Ignacio-Prieto-Romero/CoVID19/README.md

# CoVID19
Designs that can be fabricated in a Fab Lab for CoVID19
