Ignacio-Prieto-Romero/CoVID19/Corte_Laser/Gafas Rev2/README.md

<h2>Updated Version of Laser cut Protective Googles</h2>

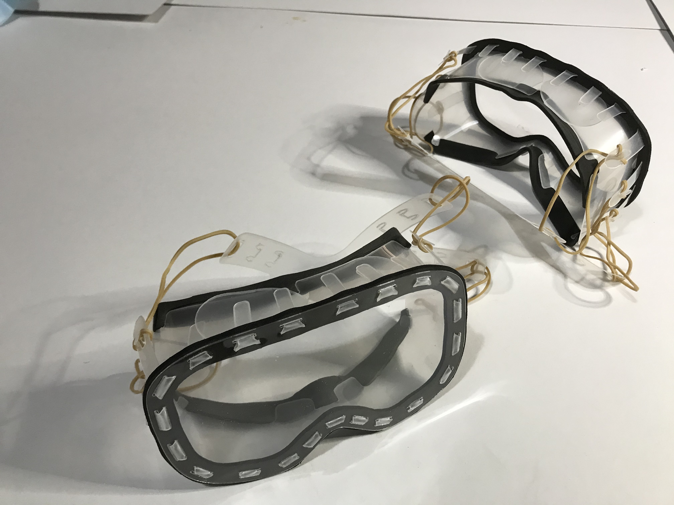
[picture p1: Corte_Laser/Gafas Rev2/IMAGES/IMG_2137.jpg]


This revision adresses concerns and issues that were stated during testing and feedback.

Main things changed are:

- Easily detachable (for sanitizing) foam inserts in the parts in contact with the face of the user.
- Changed the design of the back part that holds the rubber bands (we are using Number 14 or 140mm. diameter rubbers) to provide redundancy in case of failure and also added 1 size more, in case is needed.
- Lots little things regarding tolerances, for easier assembly process.

Important things:

We are not using rectangles anymore when cutting the PET visor. Those were so tiny, that heat resoldered them and its removal was very time consuming. No what we do is 3 different passes of straight lines with the lasercutter, defocusing them. Overall it takes much less time doing so.

Our Laser cutter is a Trotec Speedy 400 Co2 120W, so we can provide values and setup for this machine, but if you have othe machine, it'll be a little bit of trial and error, when you first test it. In order to do so, we provide a file for calibration purposes.

We also provide the file for the jig that we use to assemble the goggles. I cannot remark enough how valuable it is to speed up assembly times.

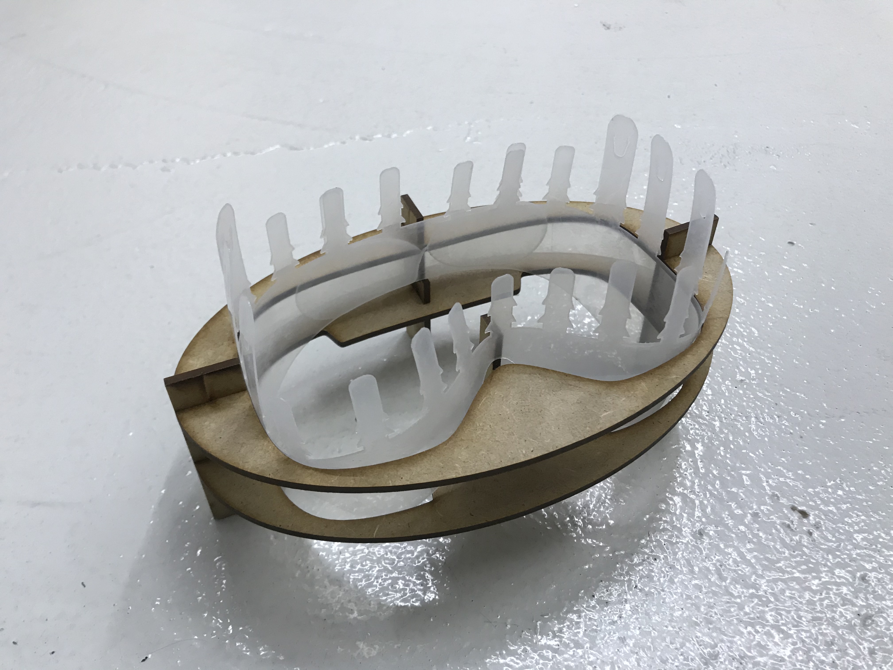
[picture p2: Corte_Laser/Gafas Rev2/IMAGES/IMG_2141.jpg]


Assembly process is pretty close to REV1

Hope you find the design useful and feel free to copy, reproduce or remix all or any part or solutions in it.

Thank you!
