Ignacio-Prieto-Romero/CoVID19/Corte_Laser/Gafas/README.md

<h2>Lasercut Protective Goggles</h2>

Desde Istituto Europeo di Design y través del de Fab Lab de su centro de innovación, hemos desarrollado un prototipo de gafas para la protección del personal sanitario, con el fin de **donarlas** a los hospitales  y contribuir a una mejor protección del personal sanitario **en reconocimiento y apoyo de su colosal labor.**

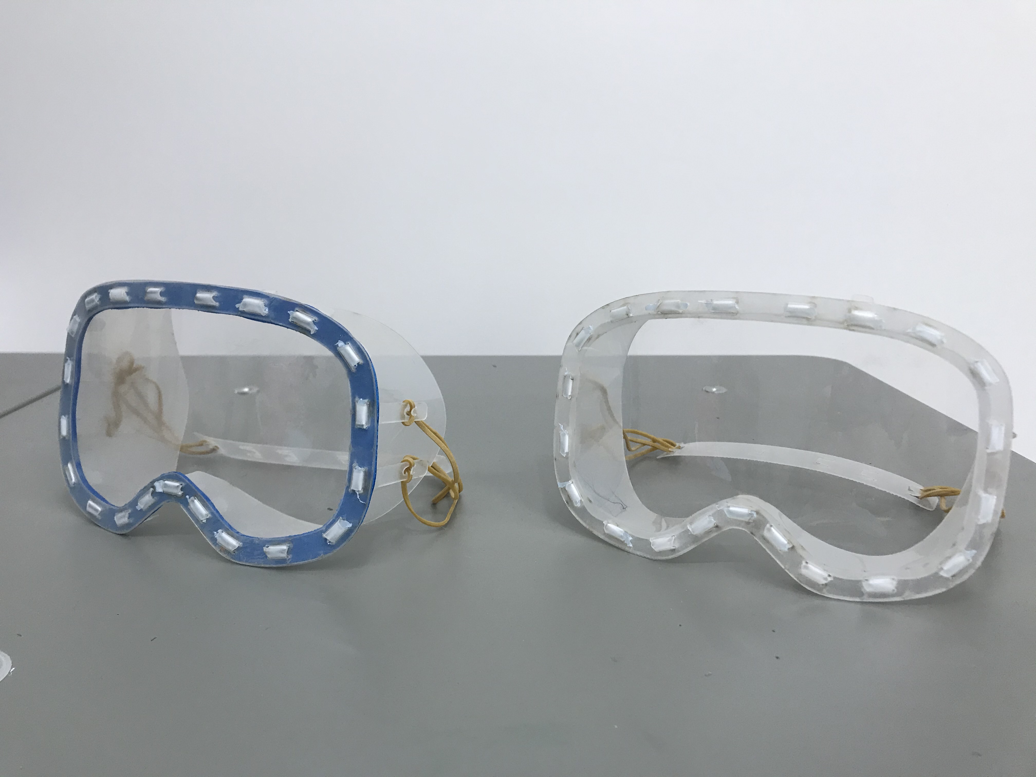
[picture p5: Corte_Laser/Gafas/images/IMG_2041.jpg]


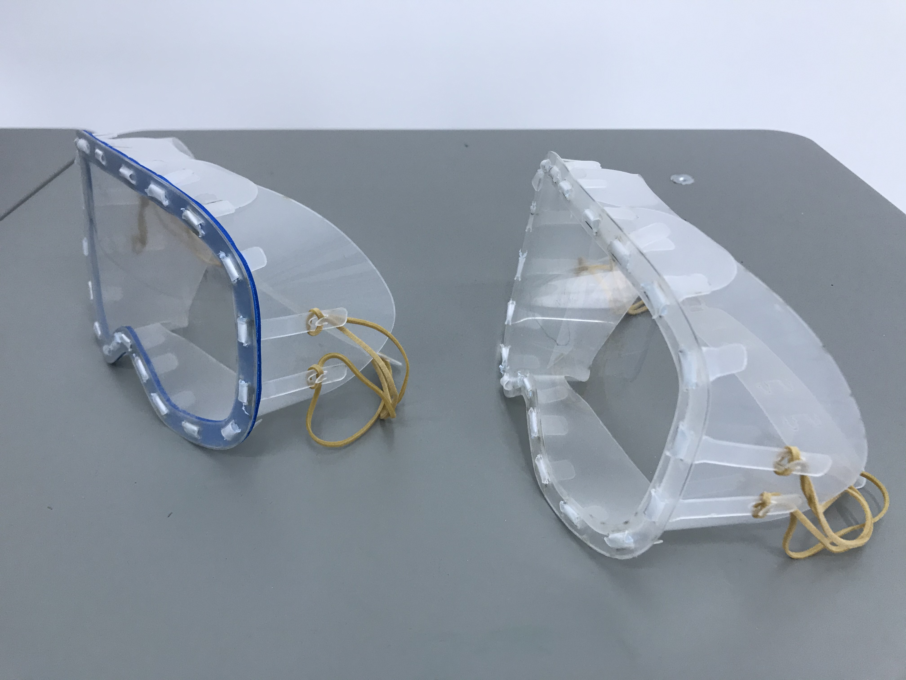
[picture p6: Corte_Laser/Gafas/images/IMG_2048.jpg]


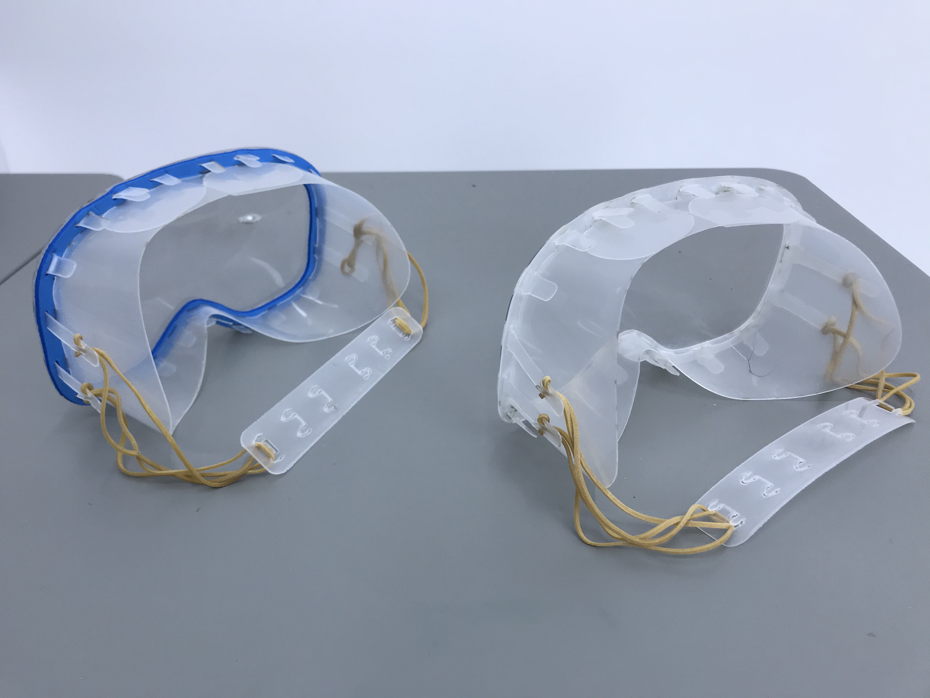
[picture p7: Corte_Laser/Gafas/images/IMG_2049.jpg]


<h4>CARACTERÍSTICAS FUNCIONALES</h4>

Las gafas se han diseñado con el propósito de **ofrecer un elevado grado de estanqueidad** evitando que el sanitario o quien las porte reciba salpicaduras, minimizando el riesgo de transmisión del coronavirus Covid-19 a través de las lágrimas y secreciones conjuntivales.

Se ha testado su capacidad anti vaho/anti empañamiento, siendo esta eficiente en entornos controlados de humedad y temperatura.

Están **diseñadas para una mejor adaptación a su uso con gafas graduadas, mascarillas y EPIs. Se recomienda especialmente su utilización con cofia y mascarilla.**

Se ajustan a la cabeza a través de unas gomas y tienen una medida estándar basada en estudios antropométricos.

<h4>CARACTERÍSTICAS DE LOS MATERIALES UTILIZADOS EN LA FABRICACIÓN</h4>

- Polipropileno 0,5mm de espesor.

Es resistente al agua, por lo que evita el traspaso de humedad y de agua, por lo que es cumple con su función de protección.

La lámina de 0,5 mm puede ser sometida a flexión o fatiga siendo altamente resistente, pudiendo adaptarse a largas jornadas de trabajo.

Se puede desinfectar y lavar mediante jabones, soluciones de alcohol, etc., ya que es muy resistente a distintos químicos. Si la esterilización que se va a practicar a los equipos es mediante ozono, como se está haciendo en otras comunidades con el material cedido, aguanta entre 10-100 ciclos de esterilización.

- Espuma de polietileno 2-3mm de espesor.

Permiten asegurar un mejor sellado en la junta mecánica frontal.

Si la esterilización se realizase mediante ozono, se podría prescindir de esta y usar polipropileno, aunque mermaría la estanqueidad.

- PETG 0,5 mm

Permite transparencia de grado óptico y aguanta esterilización por ozono.

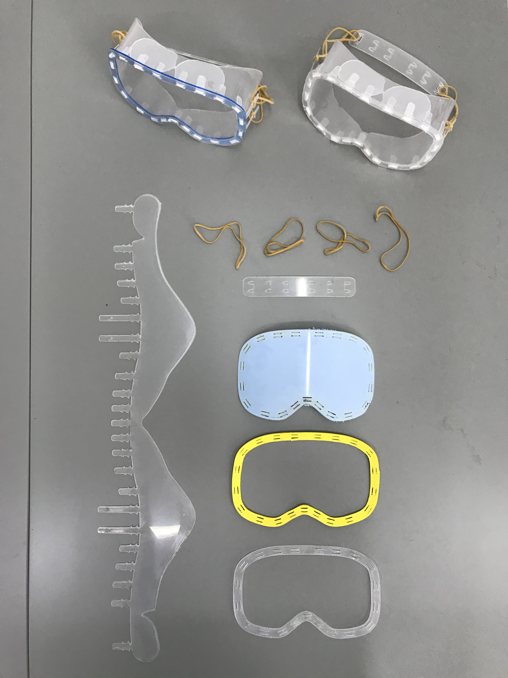
[picture p8: Corte_Laser/Gafas/images/IMG_2047.jpg]


<h4>FABRICACIÓN Y ENSAMBLAJE</h4>

Las gafas se han testado para su producción en una Trotec Speedy 400 de 120W, los parámetros dependen mucho de los materiales que se adquieran, ya que tanto la espuma, como el polipropileno son muy sensibles a estos ajustes.

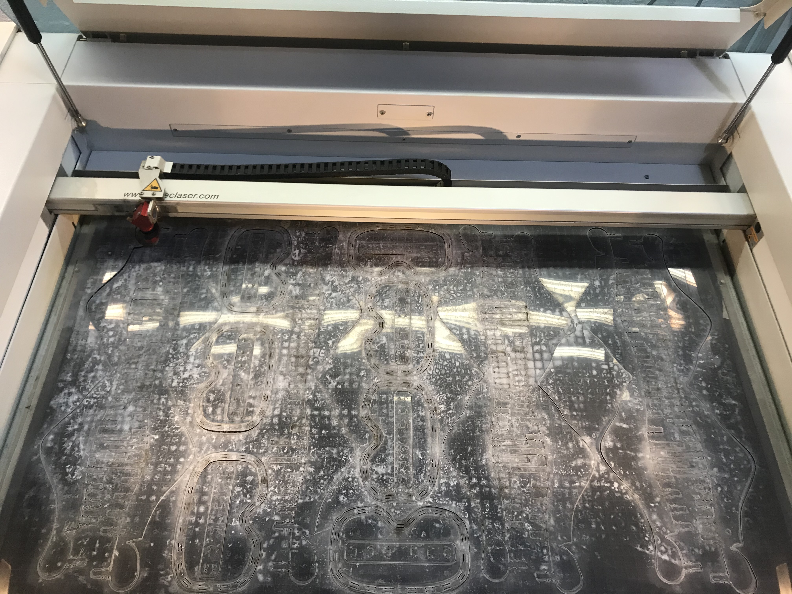
[picture p9: Corte_Laser/Gafas/images/IMG_2001.jpg]


1-Lavar el polipropileno, ya que sale con residuos del corte láser.

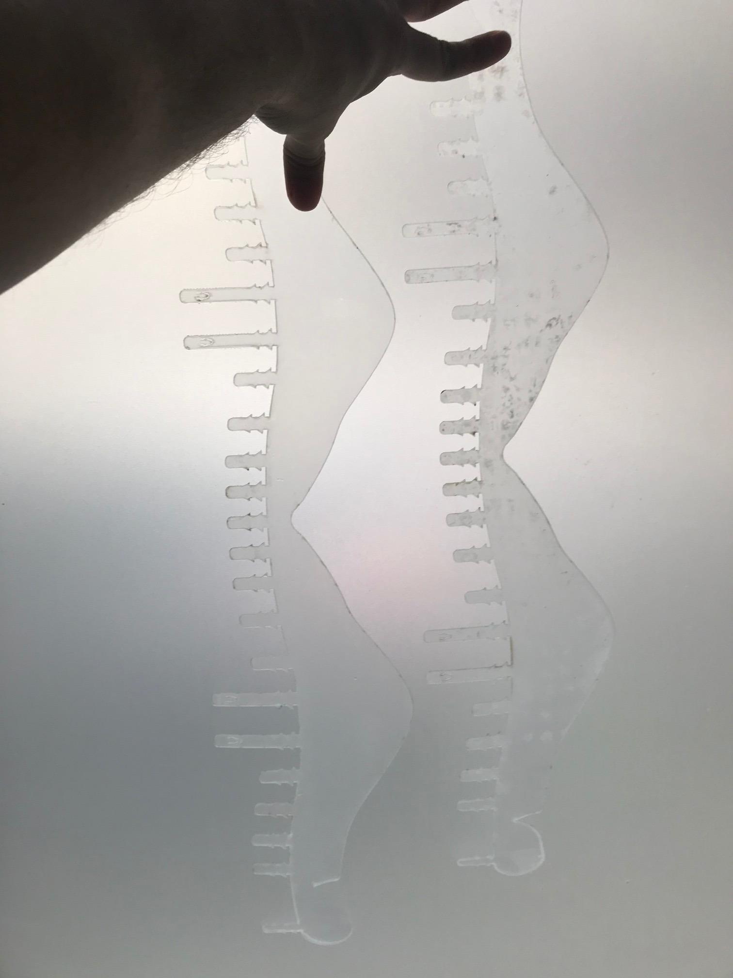
[picture p10: Corte_Laser/Gafas/images/Assembly/IMG_2055.jpg]


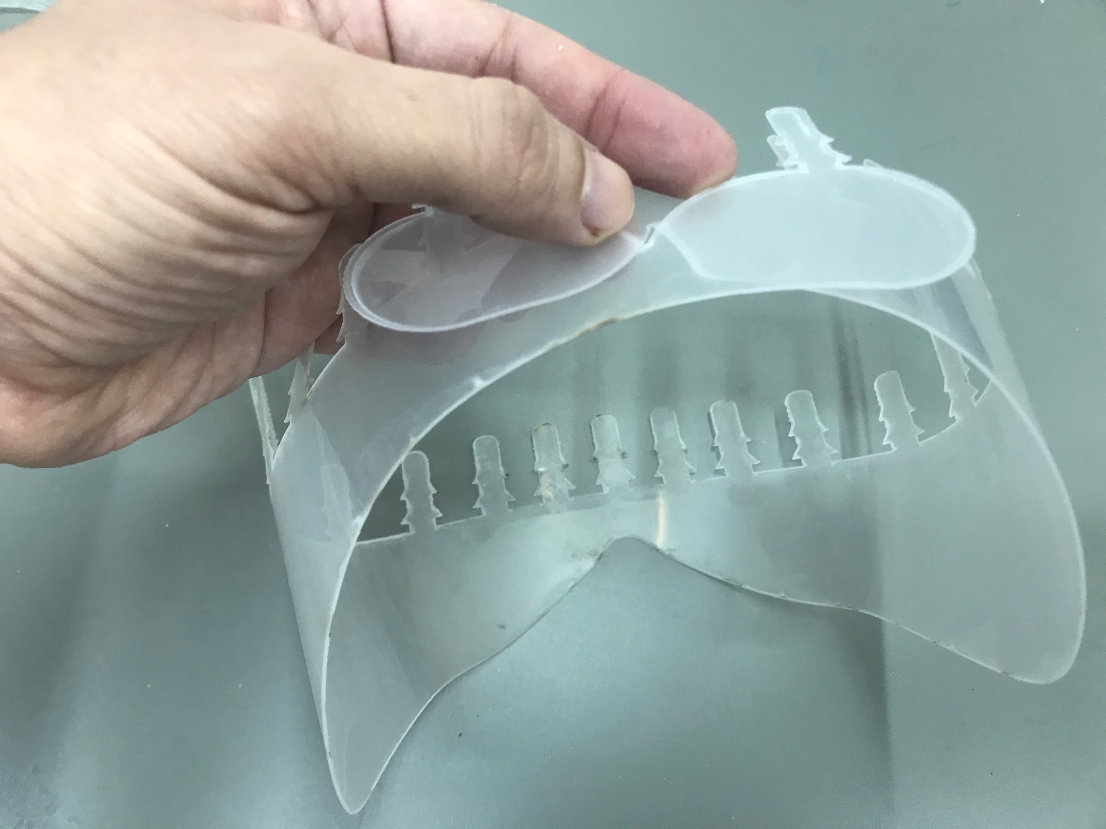
[picture p11: Corte_Laser/Gafas/images/Assembly/IMG_2056.jpg]


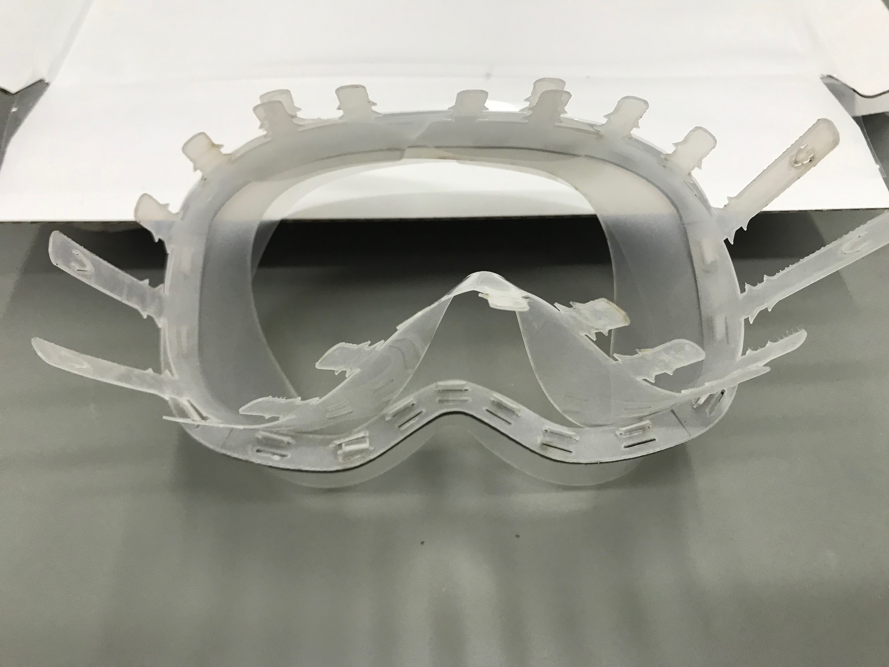
[picture p12: Corte_Laser/Gafas/images/Assembly/IMG_2058.jpg]


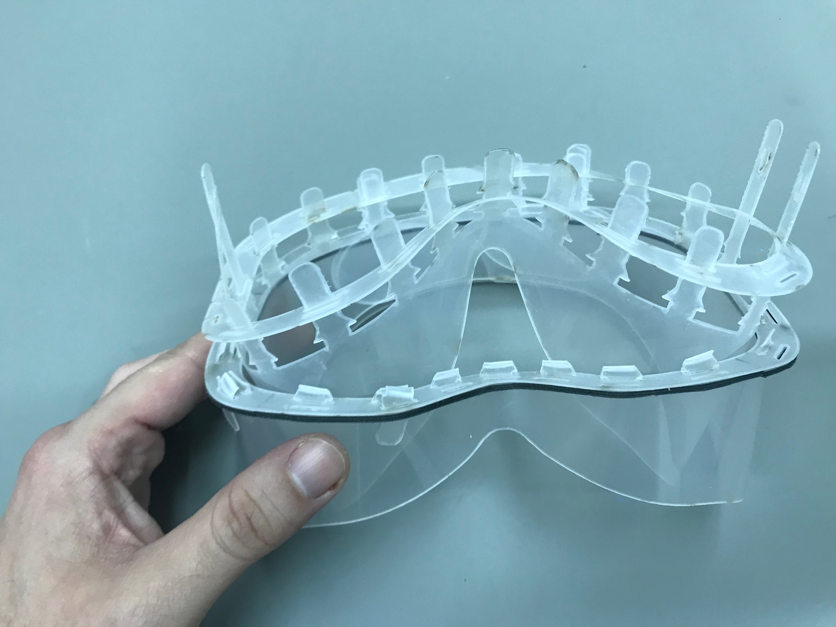
[picture p13: Corte_Laser/Gafas/images/Assembly/IMG_2060.jpg]


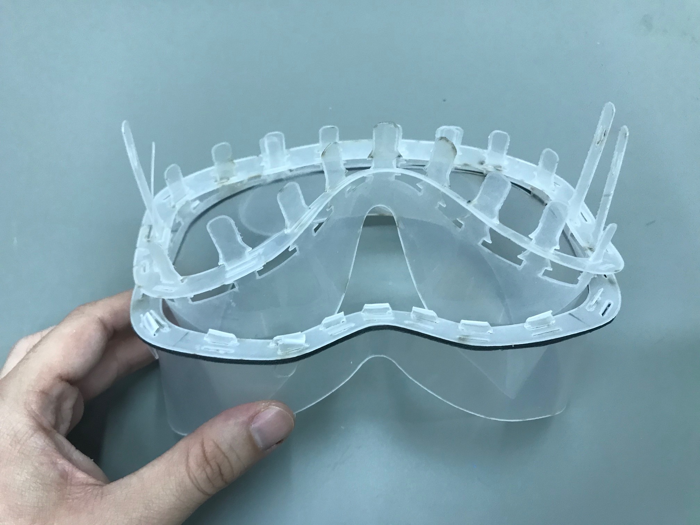
[picture p14: Corte_Laser/Gafas/images/Assembly/IMG_2061.jpg]


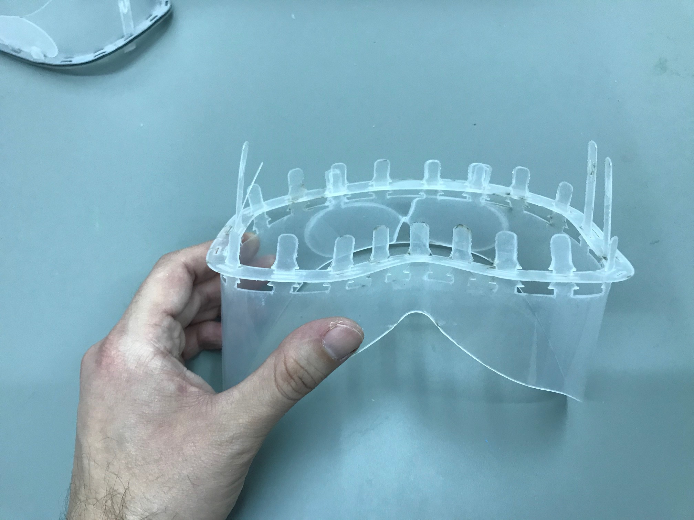
[picture p15: Corte_Laser/Gafas/images/Assembly/IMG_2062.jpg]


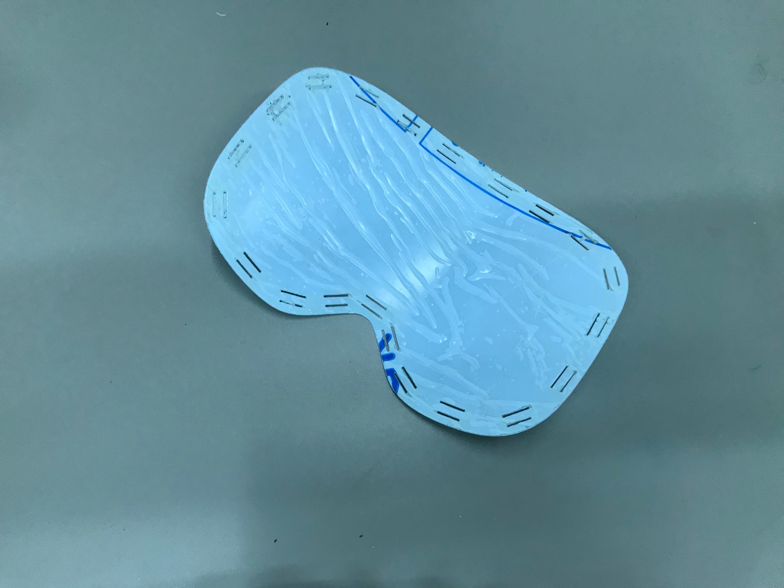
[picture p16: Corte_Laser/Gafas/images/Assembly/IMG_2063.jpg]


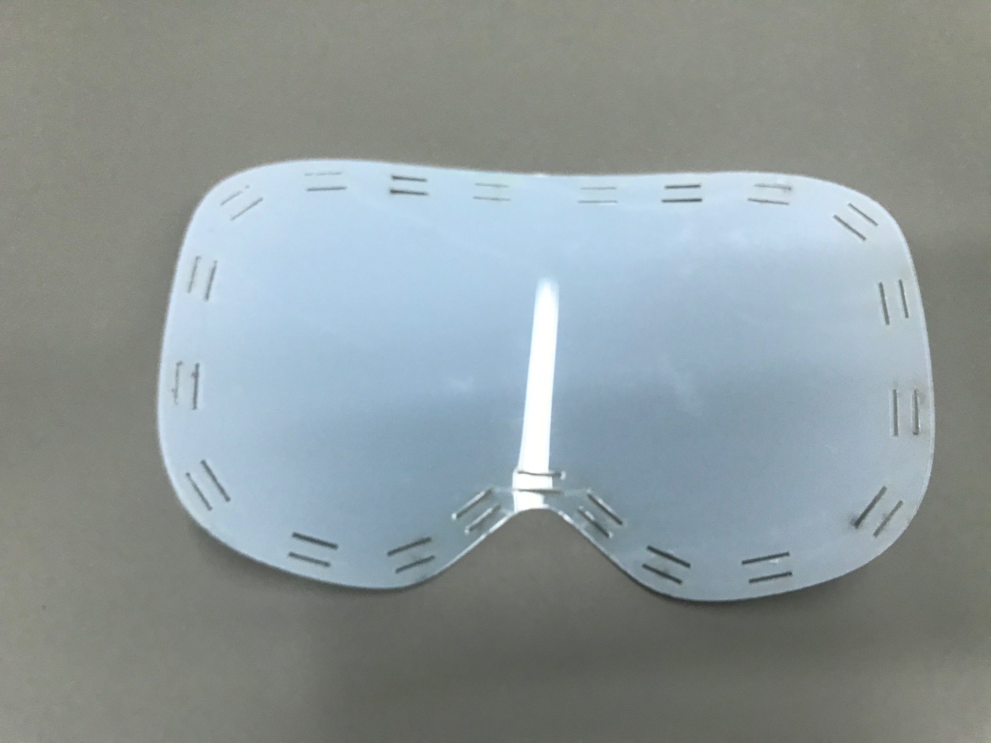
[picture p17: Corte_Laser/Gafas/images/Assembly/IMG_2064.jpg]


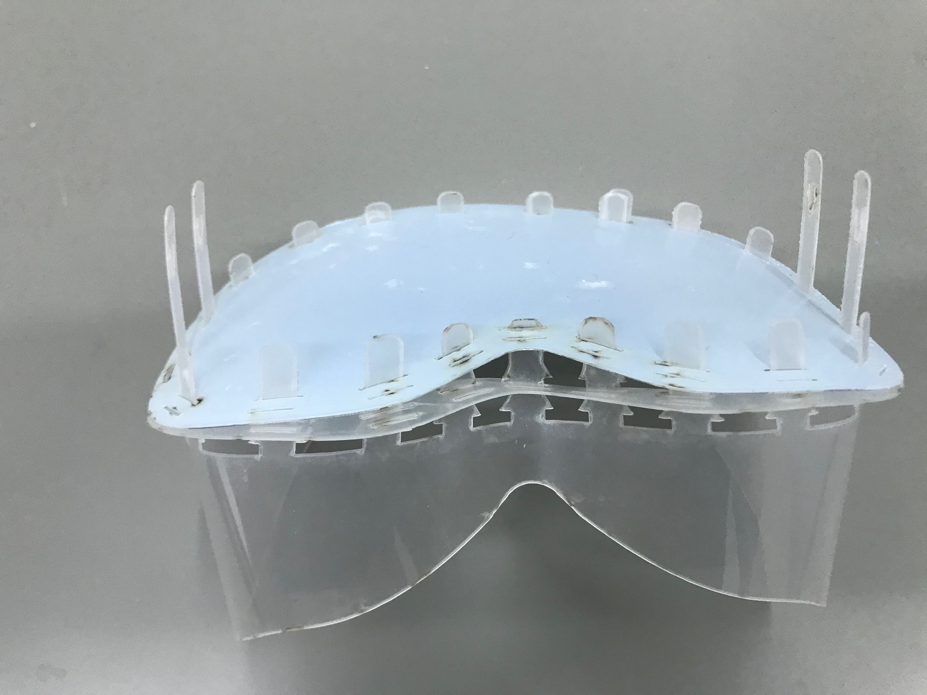
[picture p18: Corte_Laser/Gafas/images/Assembly/IMG_2065.jpg]


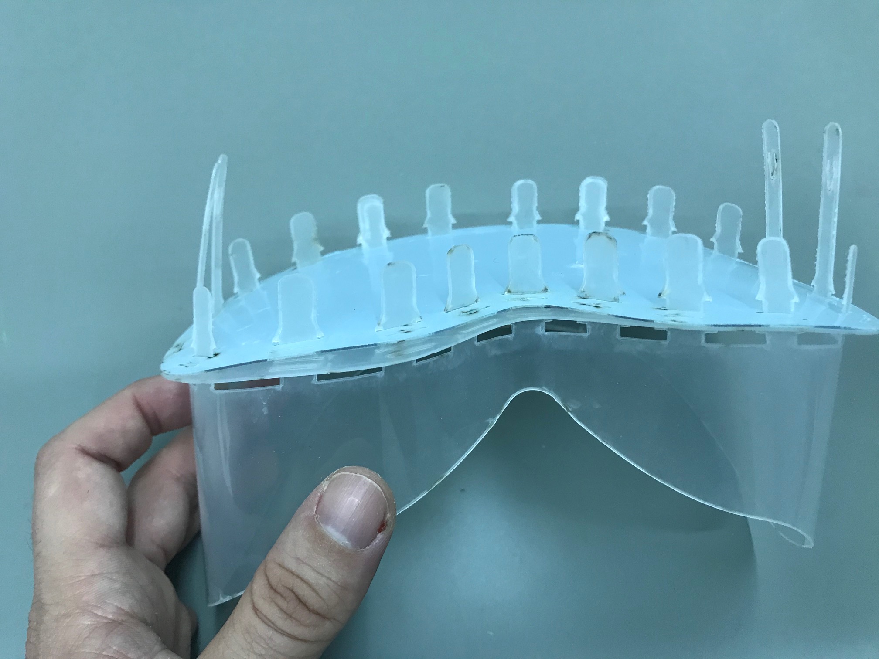
[picture p19: Corte_Laser/Gafas/images/Assembly/IMG_2066.jpg]


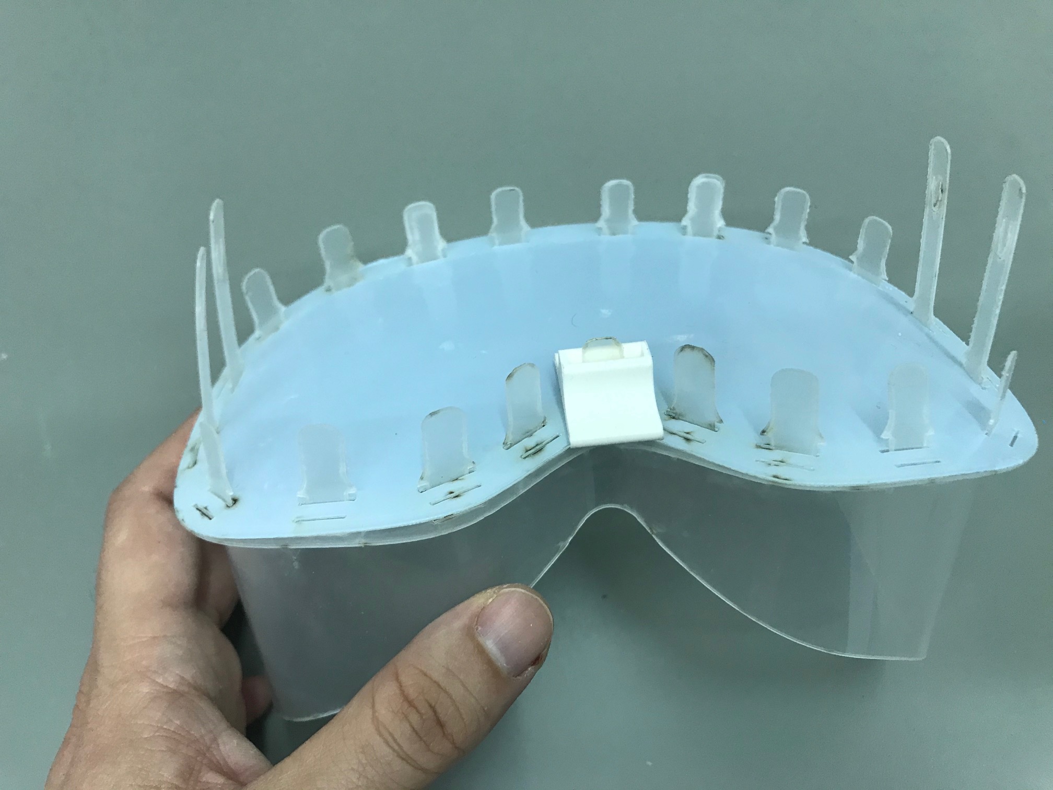
[picture p20: Corte_Laser/Gafas/images/Assembly/IMG_2067.jpg]


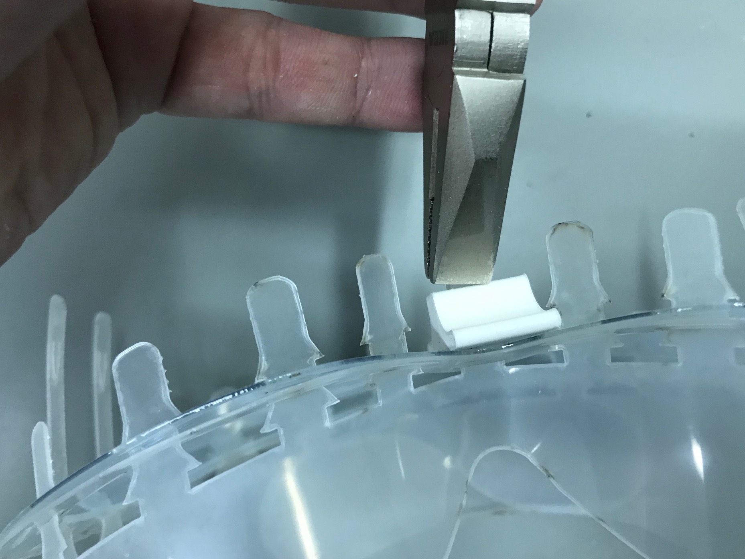
[picture p21: Corte_Laser/Gafas/images/Assembly/IMG_2068.jpg]


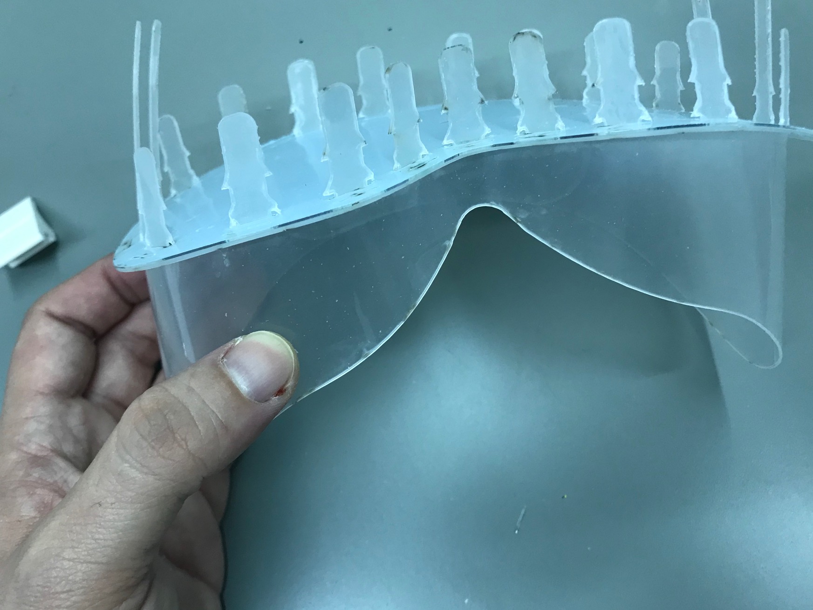
[picture p22: Corte_Laser/Gafas/images/Assembly/IMG_2069.jpg]


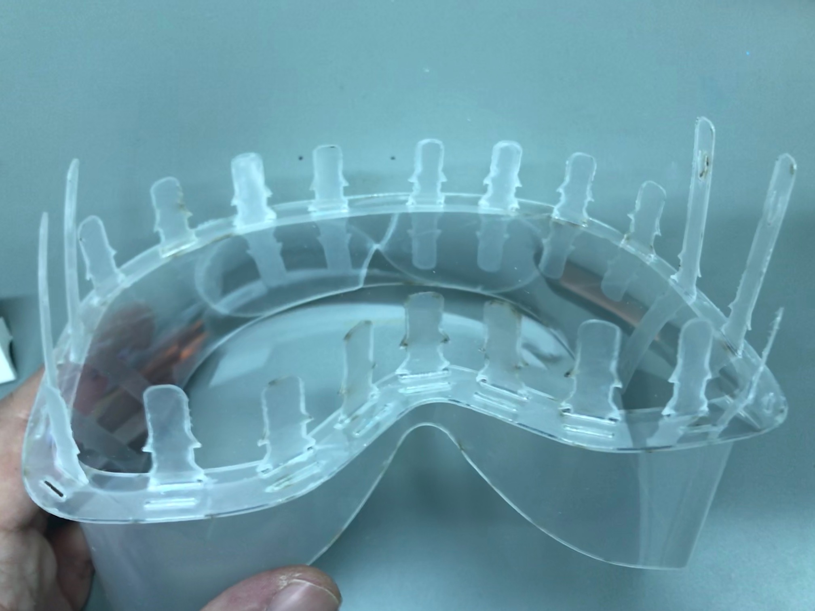
[picture p23: Corte_Laser/Gafas/images/Assembly/IMG_2071.jpg]


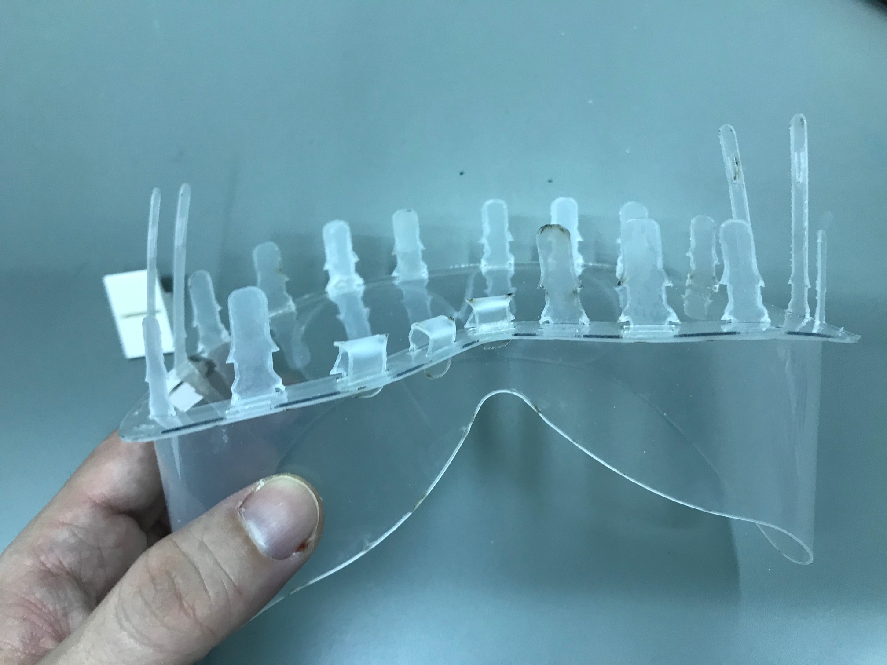
[picture p24: Corte_Laser/Gafas/images/Assembly/IMG_2072.jpg]


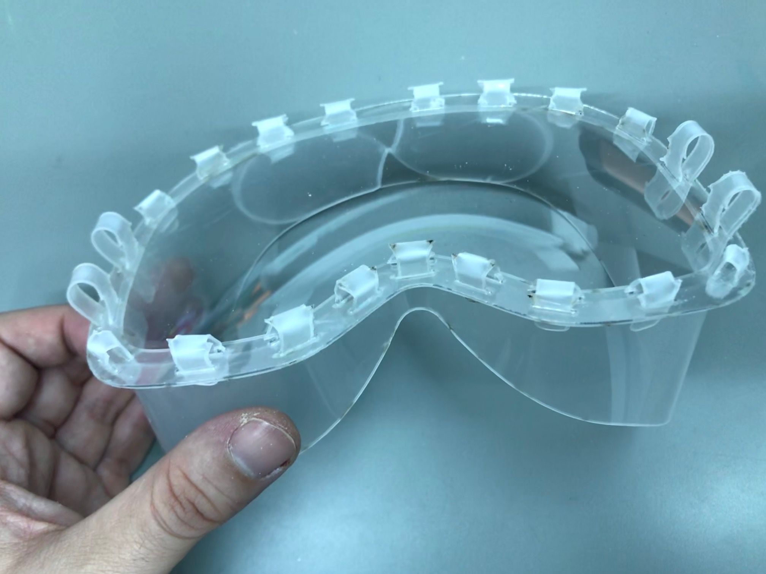
[picture p25: Corte_Laser/Gafas/images/Assembly/IMG_2073.jpg]


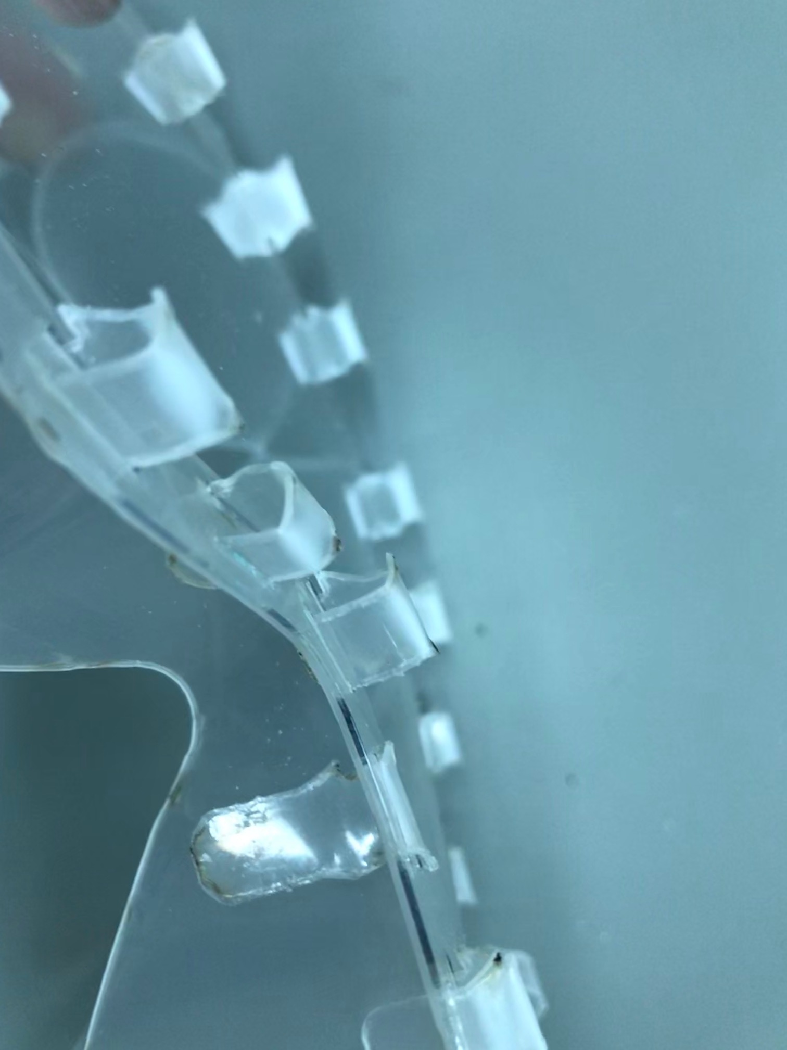
[picture p26: Corte_Laser/Gafas/images/Assembly/IMG_2074.jpg]


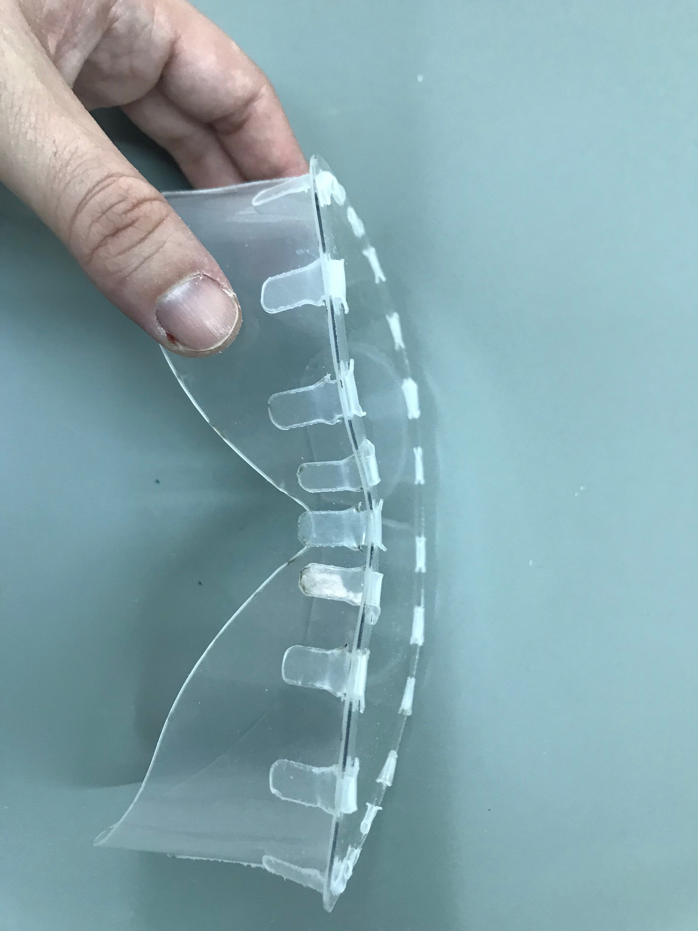
[picture p27: Corte_Laser/Gafas/images/Assembly/IMG_2075.jpg]


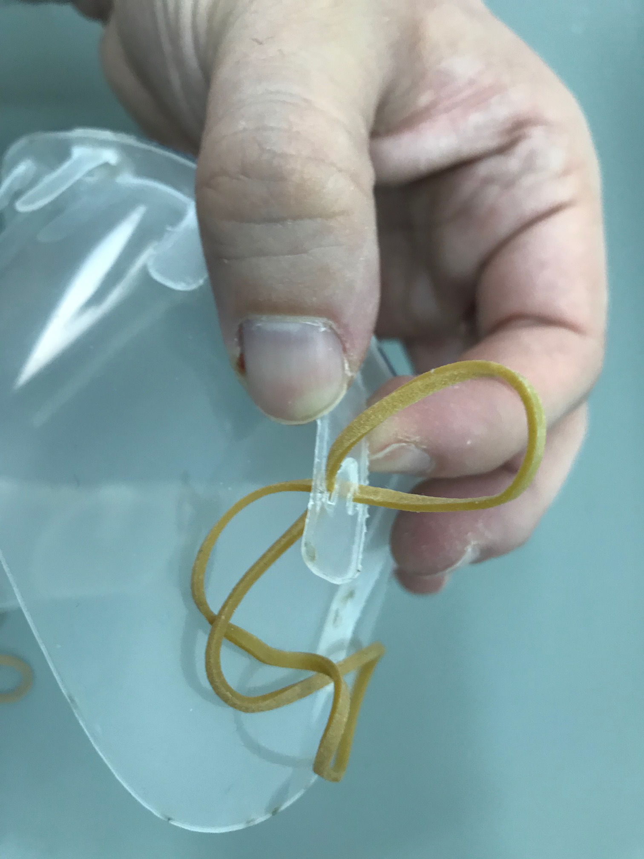
[picture p28: Corte_Laser/Gafas/images/Assembly/IMG_2076.jpg]


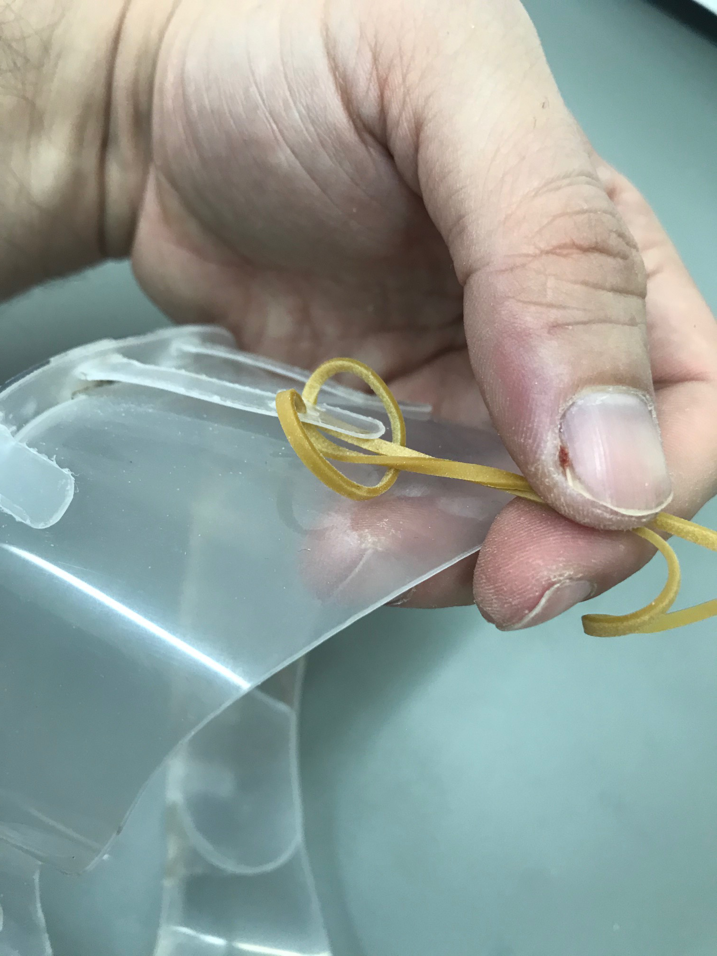
[picture p29: Corte_Laser/Gafas/images/Assembly/IMG_2077.jpg]


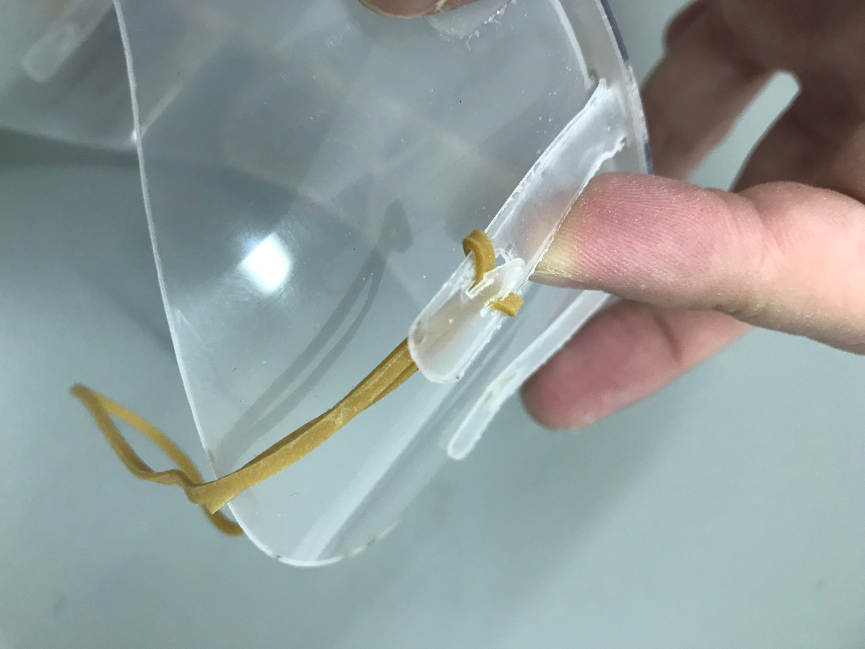
[picture p30: Corte_Laser/Gafas/images/Assembly/IMG_2078.jpg]


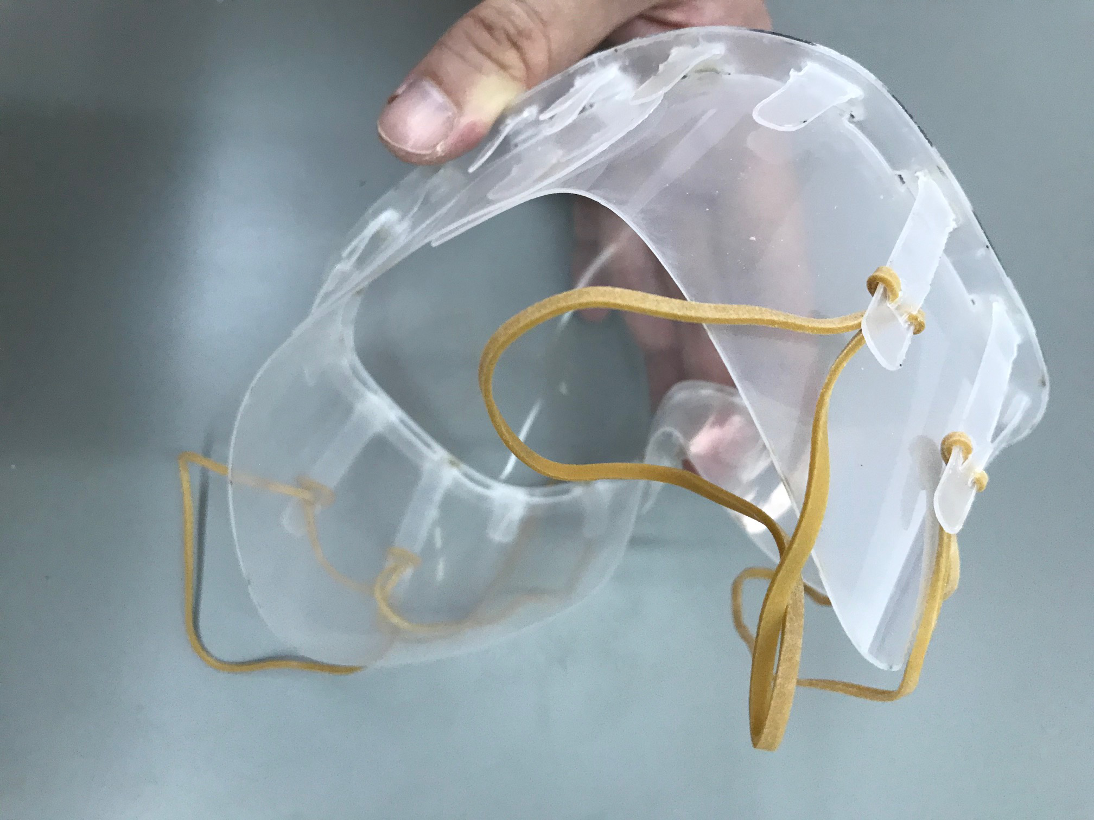
[picture p31: Corte_Laser/Gafas/images/Assembly/IMG_2079.jpg]


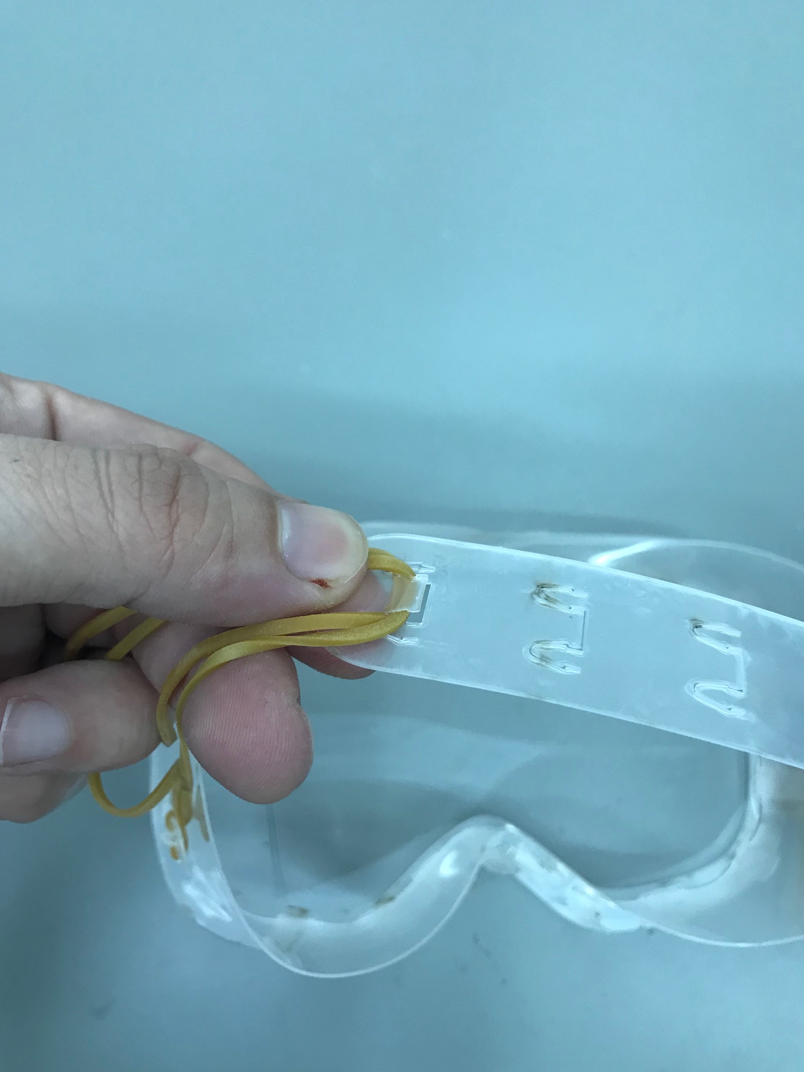
[picture p32: Corte_Laser/Gafas/images/Assembly/IMG_2080.jpg]


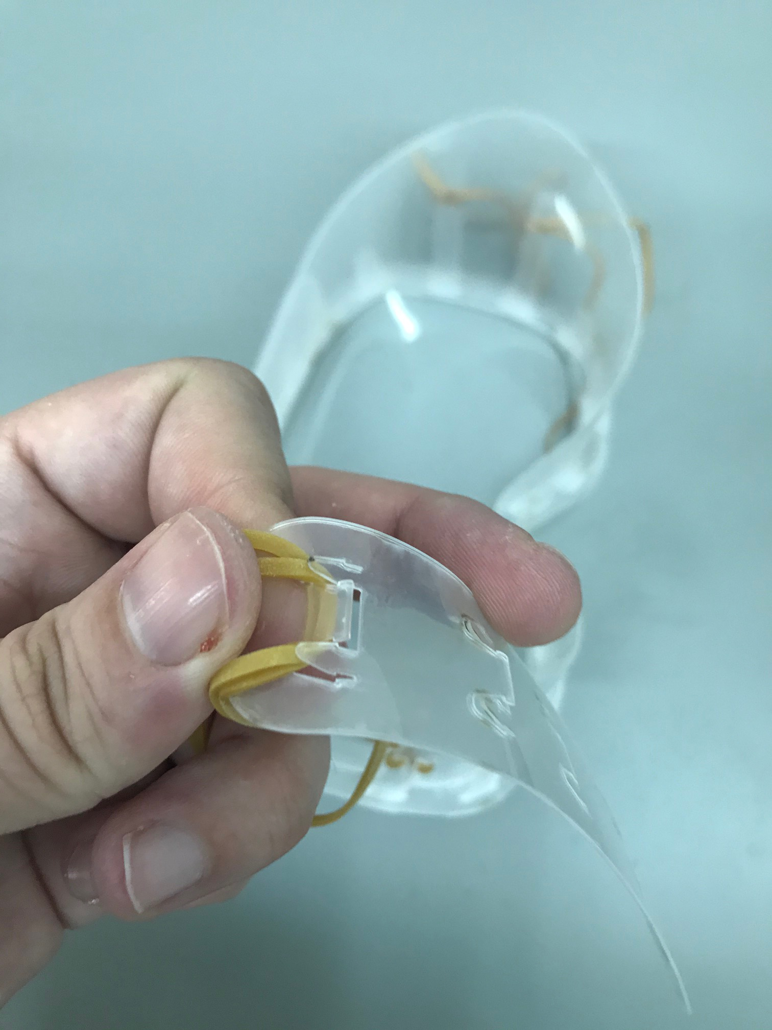
[picture p33: Corte_Laser/Gafas/images/Assembly/IMG_2081.jpg]


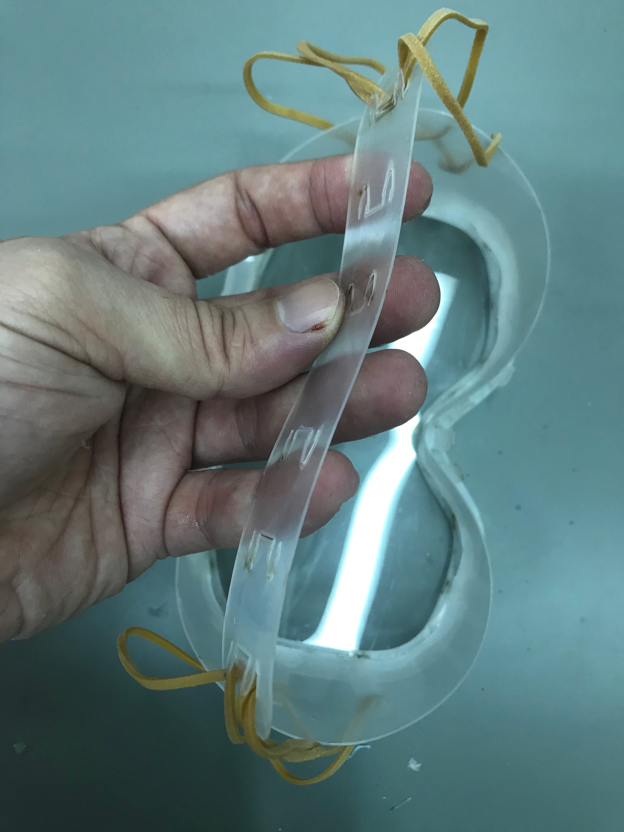
[picture p34: Corte_Laser/Gafas/images/Assembly/IMG_2082.jpg]


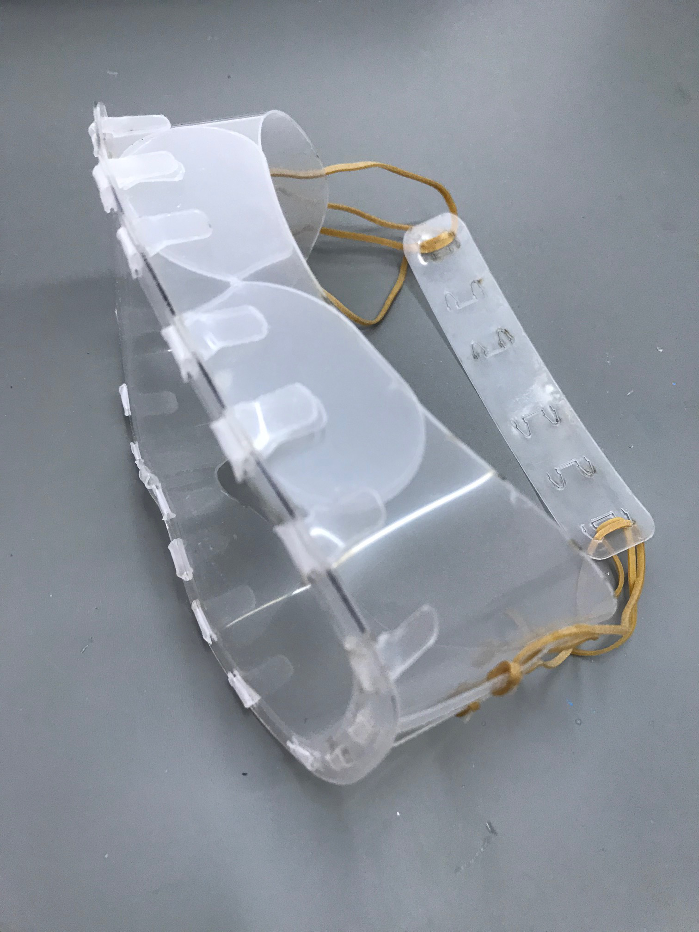
[picture p35: Corte_Laser/Gafas/images/Assembly/IMG_2083.jpg]


<h4>Partes para revisar</h4>

Estamos testando un modelo en el que las pestañas son algo mas largas, para facilitar el montaje y las que cogen la goma estan en las "esquinas superiores" de la gafa, ya que hemos comprobado que mejora el sellado al rostro.

WIP.
