Ignacio-Prieto-Romero/CoVID19/Corte_Laser/Face Mask/CAD/20200420_FaceShield_GhostPanther.pdf

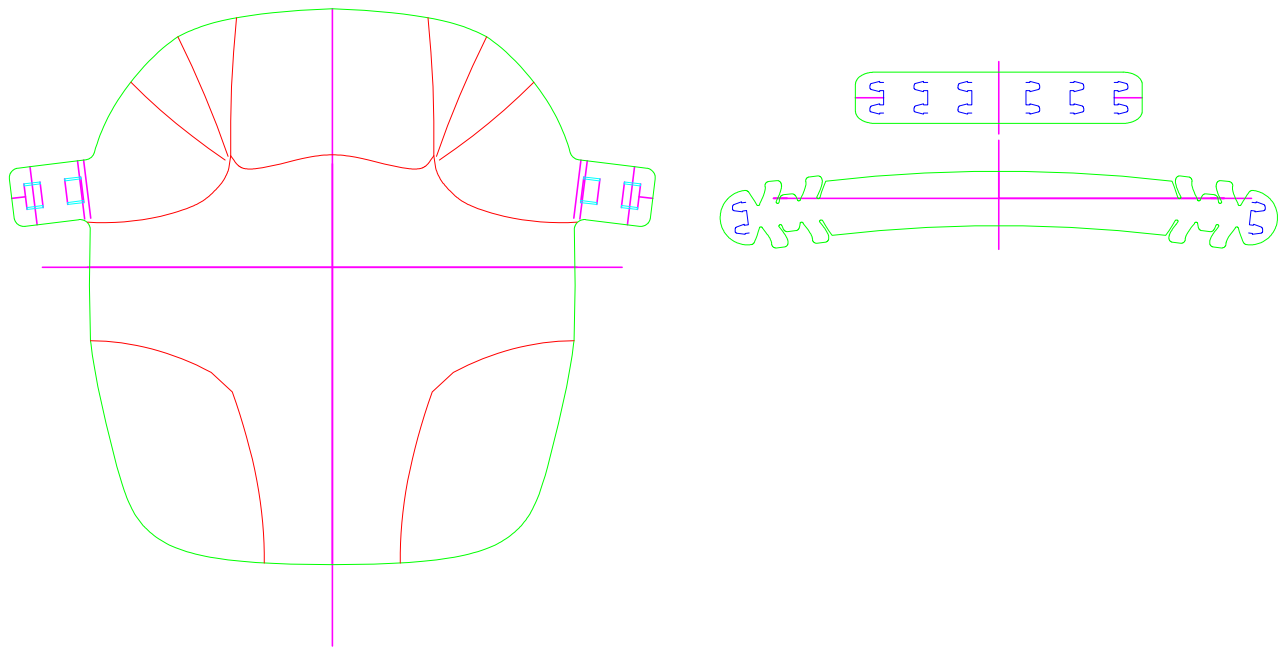
[picture p44: page 1]
