Ignacio-Prieto-Romero/CoVID19/Corte_Laser/Gafas Rev2/CAD/Protective goggles Rev2_Polyethylene foam 3mm.dxf

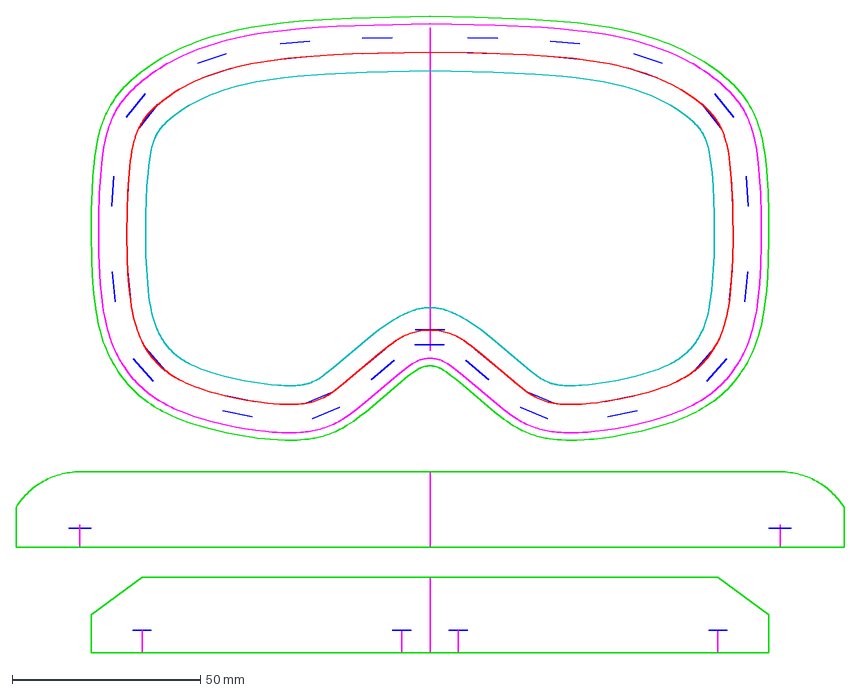
[picture p36: CAD file, 2020-04-21]
Corte_Laser/Gafas Rev2/CAD/Protective goggles Rev2_Polyethylene foam 3mm.dxf
220.0 x 169.0 mm
