Ignacio-Prieto-Romero/CoVID19/Corte_Laser/Gafas Rev2/CAD/Protective goggles Rev2_Polypropylene 500micron.dxf

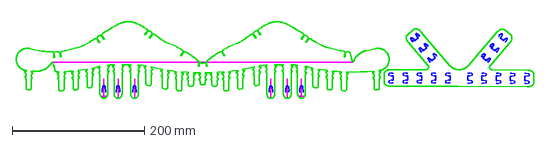
[picture p37: CAD file, 2020-04-21]
Corte_Laser/Gafas Rev2/CAD/Protective goggles Rev2_Polypropylene 500micron.dxf
782.2 x 116.0 mm
