Ignacio-Prieto-Romero/CoVID19/Corte_Laser/Gafas Rev2/CAD/Protective goggles Rev2_Tolerances Test.dxf

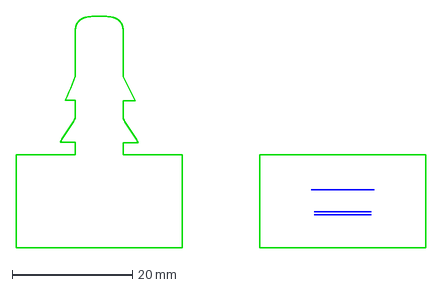
[picture p38: CAD file, 2020-04-21]
Corte_Laser/Gafas Rev2/CAD/Protective goggles Rev2_Tolerances Test.dxf
68.2 x 38.5 mm
