Ignacio-Prieto-Romero/CoVID19/Corte_Laser/Gafas Rev2/CAD/Protective goggles Rev2_PET 500-700micron.dxf

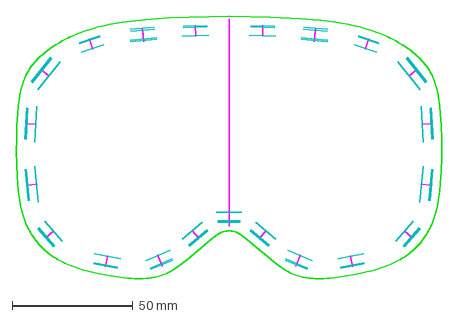
[picture p39: CAD file, 2020-04-21]
Corte_Laser/Gafas Rev2/CAD/Protective goggles Rev2_PET 500-700micron.dxf
176.1 x 108.6 mm
