Ignacio-Prieto-Romero/CoVID19/Corte_Laser/Gafas Rev2/CAD/Protective goggles Rev2_Jig_Acrylic-MDF 3mm.dxf

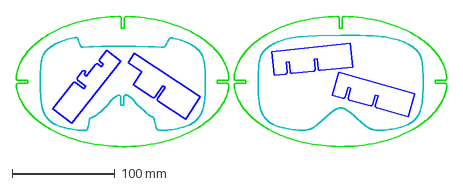
[picture p40: CAD file, 2020-04-21]
Corte_Laser/Gafas Rev2/CAD/Protective goggles Rev2_Jig_Acrylic-MDF 3mm.dxf
420.1 x 126.9 mm
