Ignacio-Prieto-Romero/CoVID19/Corte_Laser/Face Mask/CAD/20200420_FaceShield_GhostPanther.dxf

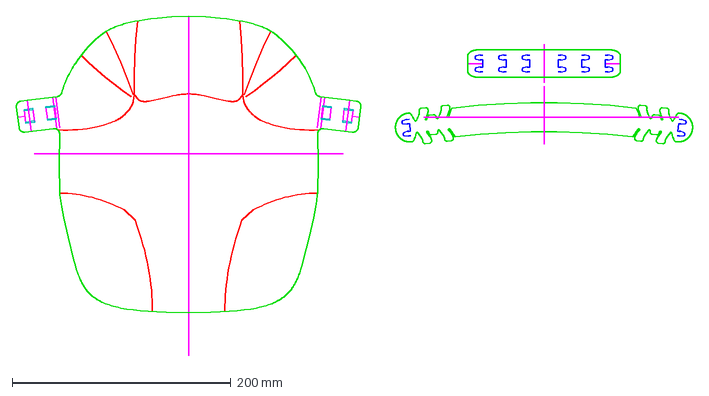
[picture p41: CAD file, 2020-04-20]
Corte_Laser/Face Mask/CAD/20200420_FaceShield_GhostPanther.dxf
618.7 x 311.1 mm
