Ignacio-Prieto-Romero/CoVID19/Corte_Laser/Gafas/CAD_Files/20200401_tools for assembly.stl

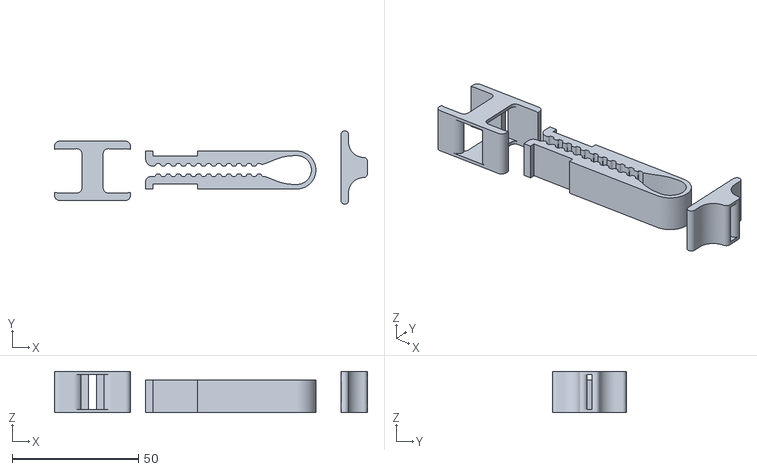
[picture p42: CAD file, 2020-04-01, an earlier design]
Corte_Laser/Gafas/CAD_Files/20200401_tools for assembly.stl
124.0 x 29.1 x 16.4
