Ignacio-Prieto-Romero/CoVID19/Corte_Laser/Gafas/CAD_Files/20200401_Goggles_IED-REV01-Clean.dxf

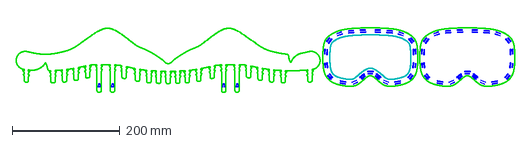
[picture p43: CAD file, 2020-04-01, an earlier design]
Corte_Laser/Gafas/CAD_Files/20200401_Goggles_IED-REV01-Clean.dxf
924.8 x 119.4 mm
