Ignacio-Prieto-Romero/CoVID19/(list of files, cad)

Other CAD files:
Corte_Laser/Face Mask/CAD/20200420_FaceShield_GhostPanther.dwg
Corte_Laser/Gafas/CAD_Files/20200401_Goggles_IED-REV01-Clean.3dm
Corte_Laser/Gafas/CAD_Files/Tools for assembly.3dm
